adolfoserique/Agym_Eletronica/Agym/Fonte 5V/PCB_FRONT.jpg

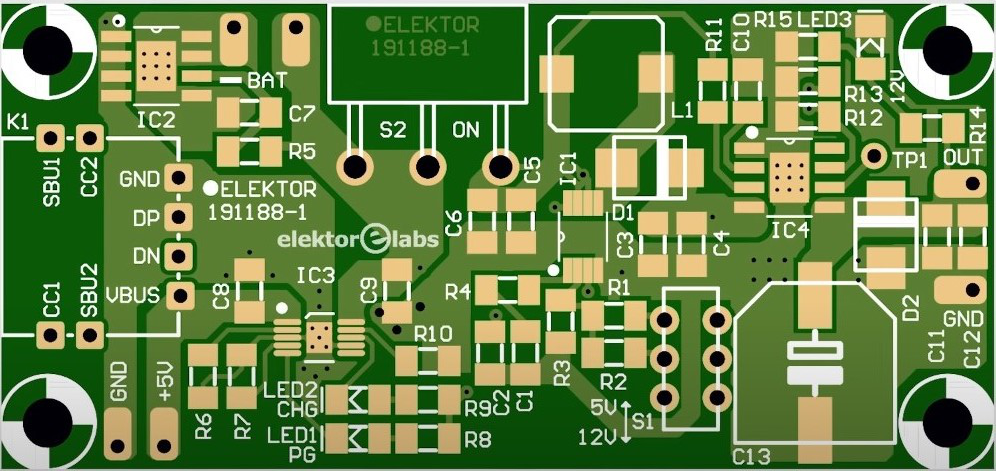
Agym/Fonte 5V/PCB_FRONT.jpg
