adolfoserique/Agym_Eletronica/Agym/Fonte 5V/PCB_BACK.jpg

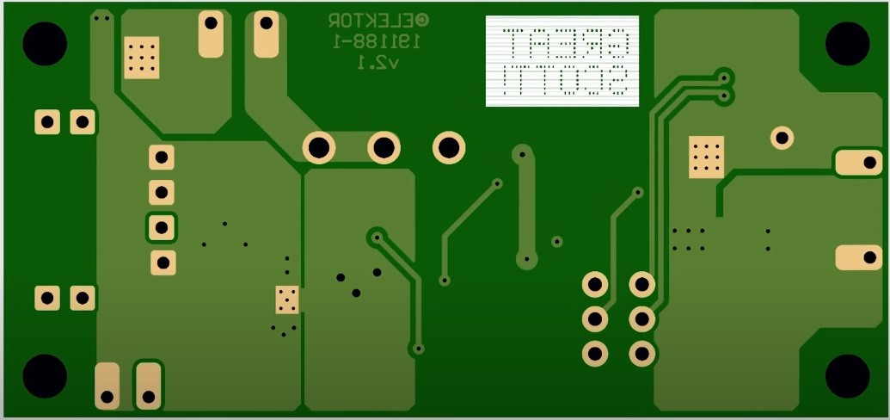
Agym/Fonte 5V/PCB_BACK.jpg
