adolfoserique/Agym_Eletronica/Agym/Peso/PCB_Project/Project Outputs for Peso/BOM/Bill of Materials-Peso.xlsx

Designator | Comment | Description | Footprint | Manufacturer Part Number | LCSC Part Number | Quantity
C1 | 10n | CAP CER 10000PF 50V C0G/NP0 0805 | C2012[0805] | CL21C103JBFNNNE | C27071 | 1
C2 | 1u | CAP CER 1UF 50V X7R 0805 | C2012[0805] | CL21B105KBFNNNE | C28323 | 1
C3 | 10u | Ceramic capacitor SMD-1206 10000nF (10uF) /25V X7R# K 10%, Samsung, RoHS/4k/ | C3216[1206] | CL31B106KAHNNNE | C14860 | 1
C4 | 10u | Ceramic capacitor SMD-1206 10000nF (10uF) /25V X7R# K 10%, Samsung, RoHS/4k/ | C3216[1206] | CL31B106KAHNNNE | C14860 | 1
C5 | 10u | Cap Ceramic 10uF 16V X7R 10% SMD 0805 125°C Emboss T/R | C2012[0805] | CL21B106KOQNNNE | C95841 | 1
C6 | 100n | CAP CER 0.1UF 50V X7R 0805 | C2012[0805] | CL21B104JBCNNNC | C62912 | 1
C7 | 10u | Cap Ceramic 10uF 16V X7R 10% SMD 0805 125°C Emboss T/R | C2012[0805] | CL21B106KOQNNNE | C95841 | 1
C8 | 10u | Cap Ceramic 10uF 16V X7R 10% SMD 0805 125°C Emboss T/R | C2012[0805] | CL21B106KOQNNNE | C95841 | 1
C9 | 47n | Prices include import duty and tax. CAP, 0.047UF, 50V, MLCC, 0603; SVHC: No SVHC (15-Jan-2019) | C1608[0603] | CL10B473KB8NNNC | C1622 | 1
C10 | 10uF | Cap Ceramic 10uF 10V X7R 20% Pad SMD 0603 125C T/R | C1608[0603] | GRM188Z71A106MA73D | C237435 | 1
C11 | 10uF | Cap Ceramic 10uF 10V X7R 20% Pad SMD 0603 125C T/R | C1608[0603] | GRM188Z71A106MA73D | C237435 | 1
C12 | 10uF | Cap Ceramic 10uF 10V X7R 20% Pad SMD 0603 125C T/R | C1608[0603] | GRM188Z71A106MA73D | C237435 | 1
C13 | 47n | Prices include import duty and tax. CAP, 0.047UF, 50V, MLCC, 0603; SVHC: No SVHC (15-Jan-2019) | C1608[0603] | CL10B473KB8NNNC | C1622 | 1
C14 | 100nF | 0603 0.1 uF 16 V ±10% Tolerance X7R Multilayer Ceramic Chip Capacitor | C1608[0603] | GRM188R71C104KA01D | C45000 | 1
C15 | 100nF | 0603 0.1 uF 16 V ±10% Tolerance X7R Multilayer Ceramic Chip Capacitor | C1608[0603] | GRM188R71C104KA01D | C45000 | 1
C16 | 220p | CL05 Series 220 pF 50 V ±5 % Tolerance C0G SMT Multilayer Ceramic Capacitor | C1005[0402] | CL05C221JB5NNNC | C307445 | 1
C17 | 220p | CL05 Series 220 pF 50 V ±5 % Tolerance C0G SMT Multilayer Ceramic Capacitor | C1005[0402] | CL05C221JB5NNNC | C307445 | 1
C18 | 10uF | Cap Ceramic 10uF 10V X7R 20% Pad SMD 0603 125C T/R | C1608[0603] | GRM188Z71A106MA73D | C237435 | 1
C19 | 47n | Prices include import duty and tax. CAP, 0.047UF, 50V, MLCC, 0603; SVHC: No SVHC (15-Jan-2019) | C1608[0603] | CL10B473KB8NNNC | C1622 | 1
CBAT | 10u | Ceramic capacitor SMD-1206 10000nF (10uF) /25V X7R# K 10%, Samsung, RoHS/4k/ | C3216[1206] | CL31B106KAHNNNE | C14860 | 1
D1 | GREEN | LED | LED-0603-G | SZYY0603G | C434420 | 1
D2 | RED | LED | LED-0603-R | SZYY0603R | C434419 | 1
F1 | Resettable Fuse |  | 0805 | SMD0805-110 | C70062 | 1
J1 | TYPE-C-31-M-17 | 6 Pins USB Type C | TYPE C - 6 PINS | TYPE-C-31-M-17 | C283540 | 1
L1 | Ferrite Bead | Ferrite Beads Multi-Layer 220Ohm 25% 100MHz 2A 45mOhm DCR 0805 Paper T/R | 0805 | BLM21PG221SN1D | C85840 | 1
L2 | Ferrite Bead | Ferrite Beads Multi-Layer 220Ohm 25% 100MHz 1.4A 100mOhm DCR 0603 Paper T/R | 0603 | MPZ1608S601ATA00 | C80165 | 1
L3 | 2u2 | Indutor | INDUTOR 3.2x2.5mm | HEI322512A-2R2M-Q8 | C285914 | 1
L4 | Ferrite Bead | Ferrite Beads Multi-Layer 220Ohm 25% 100MHz 1.4A 100mOhm DCR 0603 Paper T/R | 0603 | MPZ1608S601ATA00 | C80165 | 1
Q1 | PNP | Transistor Bipolar SOT-23 25V 300mW 500mA PNP | SOT-23-3 | S8550-2TY | C2147 | 1
R1 | 0R4 | Resistor | R3216[1206] | 1206W4F400LT5E | C247521 | 1
R2 | 1k | ERJ Series 0603 1 kOhm 0.2 W ±0.1 % ±50ppm/°C Thick Film Chip Resistor | R1608[0603] | ERJ-PB3B1001V | C193680 | 1
R3 | 1k | ERJ Series 0603 1 kOhm 0.2 W ±0.1 % ±50ppm/°C Thick Film Chip Resistor | R1608[0603] | ERJ-PB3B1001V | C193680 | 1
R4 | 1k2 | Resistor | R1608[0603] | 0603WAF1201T5E | C22765 | 1
R5 | 1k | Res Thick Film 0805 1K Ohm 1% 0.4W ±100ppm/C Epoxy Resin Pad SMD Automotive T/R | R2012[0805] | ESR10EZPF1001 | C510097 | 1
R6 | 487k | Res Thick Film 0603 487K Ohm 1% 1/10W ±100ppm/°C Molded SMD Punched Carrier T/R | R1608[0603] | ERJ-3EKF4873V | C403250 | 1
R7 | 86.6k | Res Thick Film 0603 86.6K Ohm 1% 1/10W ±100ppm/°C Molded SMD Punched Carrier T/R | R1608[0603] | ERJ-3EKF8662V | C403381 | 1
R8 | 12k | Res Thick Film 0603 12K Ohm 0.5% 1/16W ±50ppm/°C Molded SMD Punched Carrier T/R | R1608[0603] | ERJ3RBD1202V | C336849 | 1
R9 | 8k2 | Resistor | R1608[0603] | ERA3VEB8201V | C543696 | 1
R10 | 100R | Res Thin Film 0603 100 Ohm 0.1% 1/10W ±25ppm/°C Molded SMD SMD Punched Carrier T/R | R1608[0603] | ERA-3AEB101V | C445624 | 1
R11 | 100R | Res Thin Film 0603 100 Ohm 0.1% 1/10W ±25ppm/°C Molded SMD SMD Punched Carrier T/R | R1608[0603] | ERA-3AEB101V | C445624 | 1
R12 | 1k | ERJ Series 0603 1 kOhm 0.2 W ±0.1 % ±50ppm/°C Thick Film Chip Resistor | R1608[0603] | ERJ-PB3B1001V | C193680 | 1
R13 | 1k | ERJ Series 0603 1 kOhm 0.2 W ±0.1 % ±50ppm/°C Thick Film Chip Resistor | R1608[0603] | ERJ-PB3B1001V | C193680 | 1
R14 | 1k | ERJ Series 0603 1 kOhm 0.2 W ±0.1 % ±50ppm/°C Thick Film Chip Resistor | R1608[0603] | ERJ-PB3B1001V | C193680 | 1
R15 | 330R | Res Thick Film 0603 330 Ohm 1% 1/10W +/-100ppm/ßC Molded SMD Punched Carrier T/R | R1608[0603] | ERJ3EKF3300V | C278617 | 1
R16 | 330R | Res Thick Film 0603 330 Ohm 1% 1/10W +/-100ppm/ßC Molded SMD Punched Carrier T/R | R1608[0603] | ERJ3EKF3300V | C278617 | 1
R17 | 1k | ERJ Series 0603 1 kOhm 0.2 W ±0.1 % ±50ppm/°C Thick Film Chip Resistor | R1608[0603] | ERJ-PB3B1001V | C193680 | 1
R18 | 15k | Res Thick Film 0603 15K Ohm 1% 1/10W ±100ppm/°C SMD Punched Carrier T/R | R1608[0603] | ERJ-3EKF1502V | C192164 | 1
R19 | 51k | Res Thick Film 0603 51K Ohm 1% 1/10W ±100ppm/°C Molded SMD Punched Carrier T/R | R1608[0603] | ERJ-3EKF5102V | C169254 | 1
SW1 | SS-12D11G5R | Slide Switch | SS-12D11G5R | SS-12D11G5R | C692484 | 1
U1 | TP4056 | Carregador bateria 1A | SOP8-EPAD | TP4056 | C382139 | 1
U2 | XB8089D | BAT Protection | SOP8-EPAD | XB8089D | C79928 | 1
U3 | RT6150BGQW | Step-down-Step-Up 1.8V~5.5V 1.8V~5.5V 800mA 1.6A 1MHz | WDFN-10_EPAD 3x3 | RT6150BGQW | C147972 | 1
U5 | HX711 | Amplificador e A/D | SOP-16-150mil | HX711 | C43656 | 1
