adolfoserique/Agym_Eletronica/Agym/Fonte 5V/Schematic_DIY LiPo Supercharger Kit.pdf

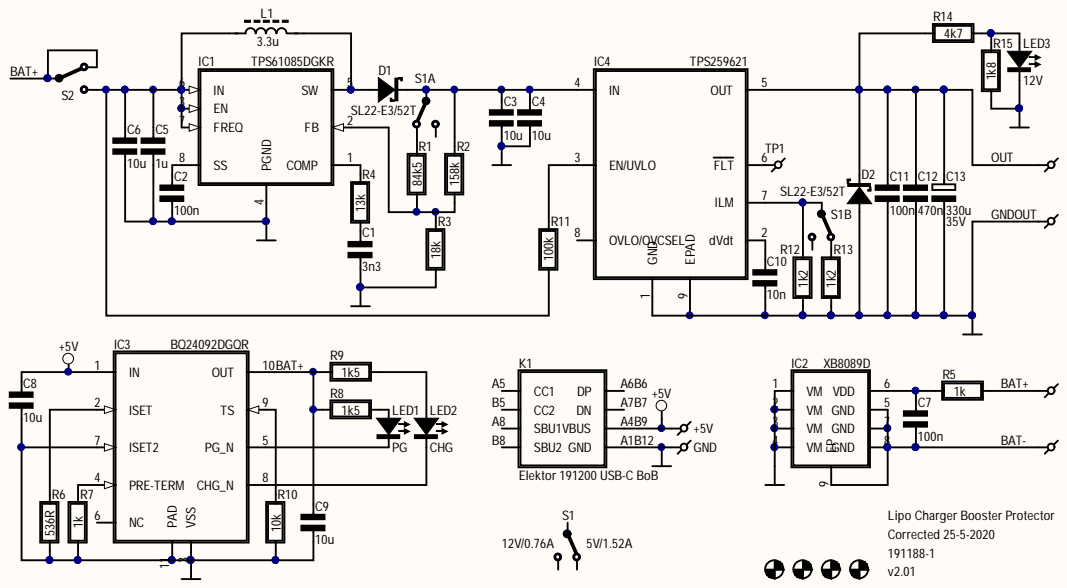
[picture p15: page 1]

Project_Title Project_Number | Modified 25.05.2020 (File_Date) | Project_Engineer

Size: A4 | Project_Revision: | Project_Fon Project_Web_Address Project_Fax Project_E_Mail_Address

Print-Date: 17.11.2020 09:27:40 Print-Time: | Sheet of
File: D:\OneDrive\Elektor International Media B.V\Content Creation - Lab - Projects\19xxxx\191188_lipo_charger_booster_protector\02_lab\hardware\191188_lipo_charger_booster_protector.SchDoc
