adolfoserique/Agym_Eletronica/(list of files, drawings)

Other design files:
Agym/PCB_Project/PCB1.PcbDoc
Agym/PCB_Project/PCB_Project.PrjPcb
Agym/PCB_Project/Sheet1.SchDoc
Agym/Peso/PCB_Project/MCU.SchDoc
Agym/Peso/PCB_Project/Peso.PrjPcb
Agym/Peso/PCB_Project/POWER.SchDoc
Agym/Peso/PCB_Project/SnapDocs/RT6150BGQW.PcbLib
